Albert-Wang1010/comm-circuits-proj/docs/Comm_Circuits_Final_Proj.pdf

# Design of a Class D AM Transmitter at 1 MHz on a Single 6 V Supply

Christopher Moronta, Caitlin O’Dea, and Albert Wang ELEN E4314, Columbia University, Spring 2026

Abstract—This paper presents the design and simulation of a Class D amplitude-modulation transmitter operating at 1 MHz on a single 6 V supply. The final stage dissipates 84 mW DC while delivering 13.0 mW into a 500 Ω load. Supply-rail modulation produces a 71 % modulation depth (FFT) at 1 kHz with 3.4 % total harmonic distortion. The −3 dB audio passband covers 250 Hz to 5000 Hz, and out-of-band emissions are more than 28 dB below the unmodulated carrier, exceeding the FCC Part 15 mask by 8 dB. The transmitter uses six bipolar transistors and one LM358 op-amp, within the project’s part budget.

I. INTRODUCTION
Although amplitude modulation has been largely supplanted in modern communication, its educational value lies in combining nonlinear switching, RF tuned networks, and audio signal processing into a compact system. A Class D output stage suits the 100 mW DC budget because the switching transistors ideally dissipate no power. We followed a backto-front design flow—tank Q and load first, then switches, RF buffer, and audio chain—and the paper follows the same order.

II. ARCHITECTURE
Fig. 1 shows the complete transmitter schematic, comprising four functional blocks. An audio bandpass filter drives a complementary push-pull buffer through an LM358 unity-gain stage. The buffer feeds the audio transformer; its secondary, in series with an RFC between VDD and the Class D supply rail, produces a low-frequency swing on the otherwise 6 V rail. An RF buffer (powered from the modulated rail, motivation in Section VII) converts the 1 Vpk carrier into base drive for the Class D switching pair, whose output passes through a series LC tank to the 500 Ω load.

III. CLASS D OUTPUT STAGE

A. Series LC Tank
The tank’s quality factor Q is set by the FCC Part 15 emission mask, which requires ≥ 20 dB attenuation at the band edges 510 kHz and 1707 kHz. For a series-tuned RLC bandpass,

H(f)
H(f0)

=

1
s
1 + Q²
f
f0

−

f0
f

2

. | (1)

Evaluating at 1707 kHz gives |f /f0 − f0/f| = 1.12, and 510 kHz gives 1.45. The upper edge is therefore the limiting case; requiring 20 dB attenuation yields Q ≥ 9. We chose

Q = 10 to provide tolerance margin without compressing the audio sidebands at ±5 kHz around the carrier.
With RL = 500 Ω and ω0 = 2π × 1 MHz,

L1 =

QRL
ω0

= 796 µH → 820 µH (standard), (2)

C1 =

1
ω

2
0L1

= 30.9 pF → 30 pF (standard), (3)

giving a measured Q = 10.3 and f0 = 1.015 MHz. The residual offset falls well inside the audio passband and is absorbed by the variable trimmer (10 pF to 500 pF).

B. Complementary Switching Pair
The output transistors are a 2N2907A high-side PNP (Q1, emitter on rail) and a 2N2222A low-side NPN (Q2, emitter on ground), driven 180°out of phase by the RF buffer. Base resistors R2 = R3 = 2.2 kΩ set quiescent base currents of approximately 200 µA, sufficient to saturate each device given βDC > 100 at peak collector currents on the order of 10 mA. The choice of R2,3 has a strong effect on DC power: increasing from 1 kΩ to 2.2 kΩ dropped dissipation from 108 mW to 84 mW, since lighter base loading allows fuller rail swing and reduces conduction overlap.
Speed-up capacitors C9 (across R2) and C2 (across R3), 330 pF each, accelerate switching transitions by bypassing the base resistor at high frequencies. Without them, the RC time constant formed by the base resistor and transistor input capacitance (∼ 25 pF) gives τ ≈ 55 ns, which is significant against the 500 ns carrier half-period. This slow slew rate allows the switching node to traverse its active region gradually, causing brief shoot-through pulses that pull Vrail down through parasitic coupling, wasting DC power. At 1 MHz, the capacitor reactance (≈ 482 Ω) falls well below 2.2 kΩ, so the fast edge bypasses the resistor and charges the base directly, while the resistor still sets the DC bias current limit. We found empirically that 680 pF over-couples and drives the transistor into deep saturation, causing excessive trough overshoot at turn-off, while 330 pF provides the optimal balance between edge speed and overshoot suppression.

IV. RF INPUT BUFFER
The 1 Vpk RF source drives a 2N2222A common-emitter amplifier Q3 through a 100 nF DC-blocking capacitor. The bias divider R7 = 7.5 kΩ and R5 = 680 Ω is referenced to the modulated rail, placing Q3 just below conduction threshold so it operates in Class C with ∼ 30 % duty cycle. This is

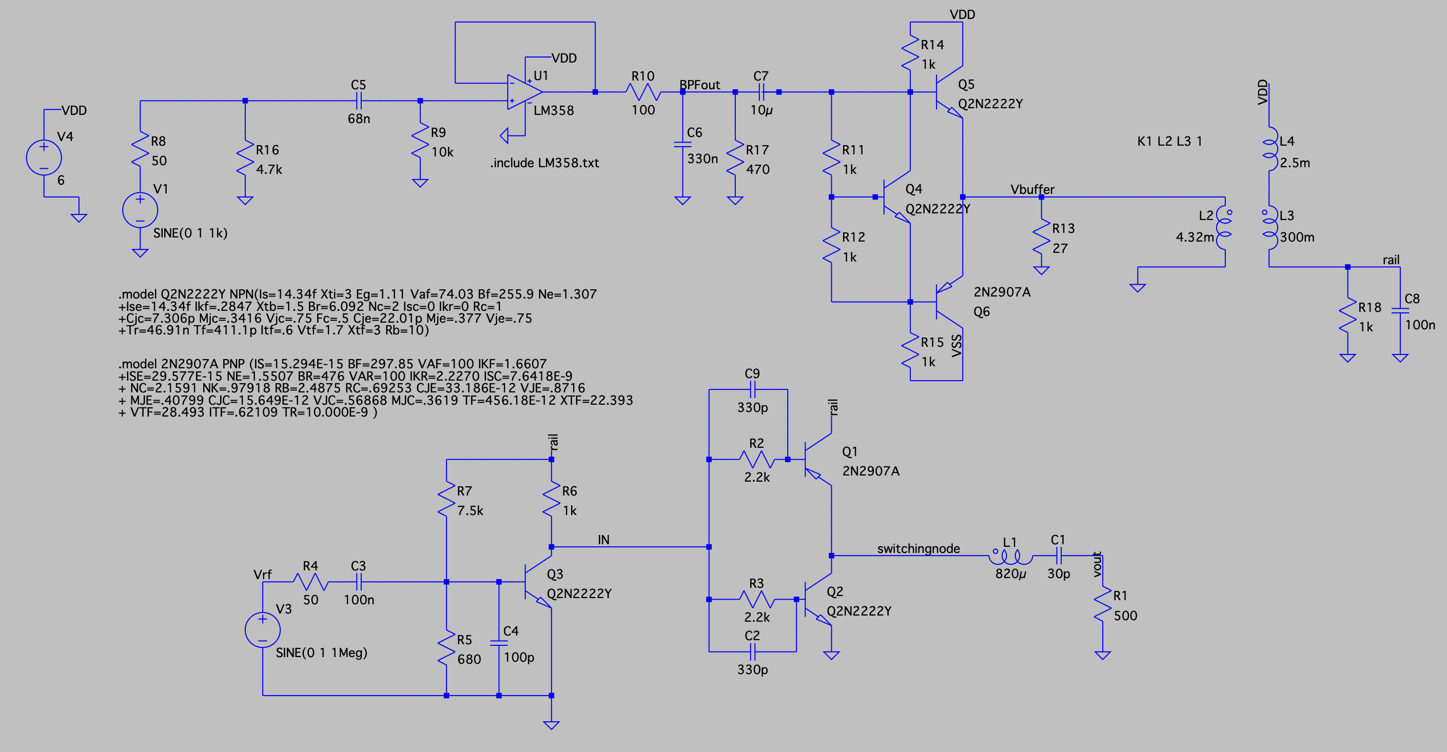
[picture p1: figure]

Fig. 1. Complete LTspice schematic. Top-left: audio bandpass filter and unity buffer (LM358). Top-center: complementary push-pull current buffer with VBE-multiplier biasing (Q4). Top-right: audio transformer (used in reverse for 8.33× step-up) and rail network (RFC L4, bypass C8). Bottom-left: RF input buffer (Q3, Class C). Bottom-right: Class D switching pair (Q1, Q2) and series-LC output tank (L1, C1) into RL = 500 Ω.

acceptable because the high-Q tank rejects all harmonics,
leaving only the 1 MHz fundamental at the switching node.
A 100 pF bypass capacitor C4 across R5 stabilizes the base AC reference. Because R7 is tied to the modulated rail, residual switching ripple and audio-frequency variation would otherwise reach the base and jitter the Class C conduction threshold cycle-to-cycle. C4 shunts these components to ground, locking the threshold and producing a consistent near-square waveform at the collector.
The collector resistor R6 = 1 kΩ delivers a rail-to-rail drive to the bases of Q1 and Q2. Because VR5,R7
scales with
the rail, the buffer’s quiescent point tracks the modulation and the carrier amplitude at the switching node remains a linear function of rail voltage; this linearity is the principal contributor to the low achieved THD.
V. AUDIO MODULATION CHAIN
A. Bandpass Filter
The audio source provides 1 Vpk through a 50 Ω series resistance. A passive high-pass section formed by C5 = 68 nF and R9 = 10 kΩ sets the lower −3 dB corner:

fHP =

1
2πR9C5
= 234 Hz. | (4)

The signal then passes through an LM358 unity-gain buffer U1 (non-inverting input bias set by R9). A passive low-pass section follows, with series R10 = 100 Ω feeding a node loaded by C6 = 330 nF in parallel with R17 = 470 Ω to ground. R17 serves two roles simultaneously: as a DC divider it attenuates by R17/(R10 + R17) = 0.825, trimming the modulation depth from 84 % to the target 71 %; and as part of the Thevenin resistance seen by C6, it sets the upper corner

fLP =

1
2π(R10 ∥ R17) C6
= 5.85 kHz. | (5)

The 234 Hz HPF corner sits closest to the spec edge and proves the tighter of the two endpoints (Section VI).

B. Push-Pull Audio Buffer

The LM358 cannot supply the heavy current required by the transformer primary, whose impedance falls below 10 Ω at the low end of the audio band; a complementary emitter-follower pair (2N2222A Q5 and 2N2907A Q6) provides the necessary current gain. To prevent crossover distortion the bases must be biased ∼ 2VBE apart. Since diodes are not permitted by the part list, we use a VBE multiplier (Q4, 2N2222A) with R11, R12 = 1 kΩ and chain resistors R14, R15 = 1 kΩ setting the quiescent point. Q4’s VCE settles at VBE(1 + R12/R11) and tracks temperature. R13 = 27 Ω at the buffer output establishes a static DC reference for Vbuffer.

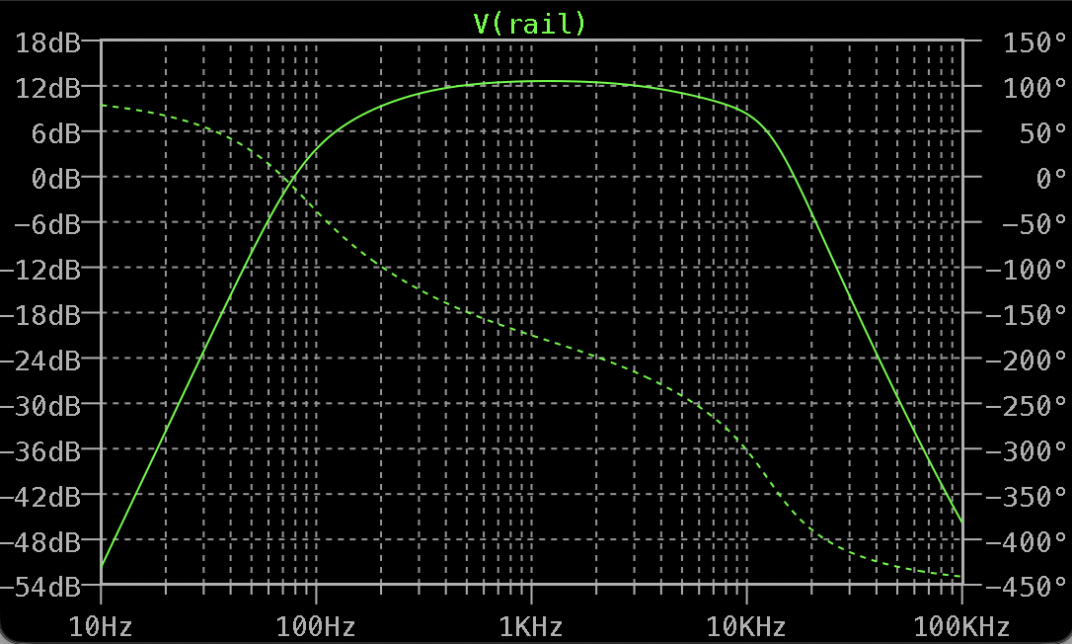
[picture p2: figure]

Fig. 2. Simulated audio-chain transfer function (AC sweep from 10 Hz to 50 kHz). Markers at the −3 dB points indicate the 234 Hz HPF and 5.85 kHz LPF corners, bracketing the required 250 Hz to 5000 Hz audio passband.

C. Transformer and Rail Filtering

The audio transformer is the Mouser 42TL001 (Lp = 300 mH, n = 8.333), connected in reverse so that the 4.32 mH winding (1.1 Ω series resistance) is driven by the push-pull buffer and the 300 mH winding (35 Ω series resistance) couples into the rail. This 8.33× voltage step-up allows a modest buffer swing of ±0.5 Vpk to produce the ±4.2 Vpk of audio swing required for m = 0.7 on a 6 V rail.
The transformer secondary is placed in series with a 2.5 mH RFC (L4) between VDD and the Class D rail. The RFC presents high impedance to 1 MHz switching ripple while passing the audio signal essentially unattenuated, and a 100 nF bypass capacitor C8 shunts residual RF content to ground.

VI. SIMULATION RESULTS

All simulations were performed in LTspice with the manufacturer SPICE models for the 2N2222A, 2N2907A, and LM358. The .tran 0 20m 5m 20n command was used with a 20 ns maximum timestep to resolve the 1 MHz carrier; the first 5 ms was discarded as startup transient. Per the spec, the SPICE power option is not used; all power quantities are computed from voltage and current via .meas commands.

A. Modulated Output and Rail Waveform

Fig. 3 shows the output voltage Vout across RL with 1 kHz audio, displaying clean amplitude modulation of the 1 MHz carrier (envelope between ∼0.93 Vpk and ∼5.5 Vpk). Fig. 4 shows the corresponding rail waveform: it swings between Vrail,max = 9.19 V and Vrail,min = 1.85 V, giving a rail-based modulation depth

mrail =

Vmax − Vmin

Vmax + Vmin

= 0.665. | (6)

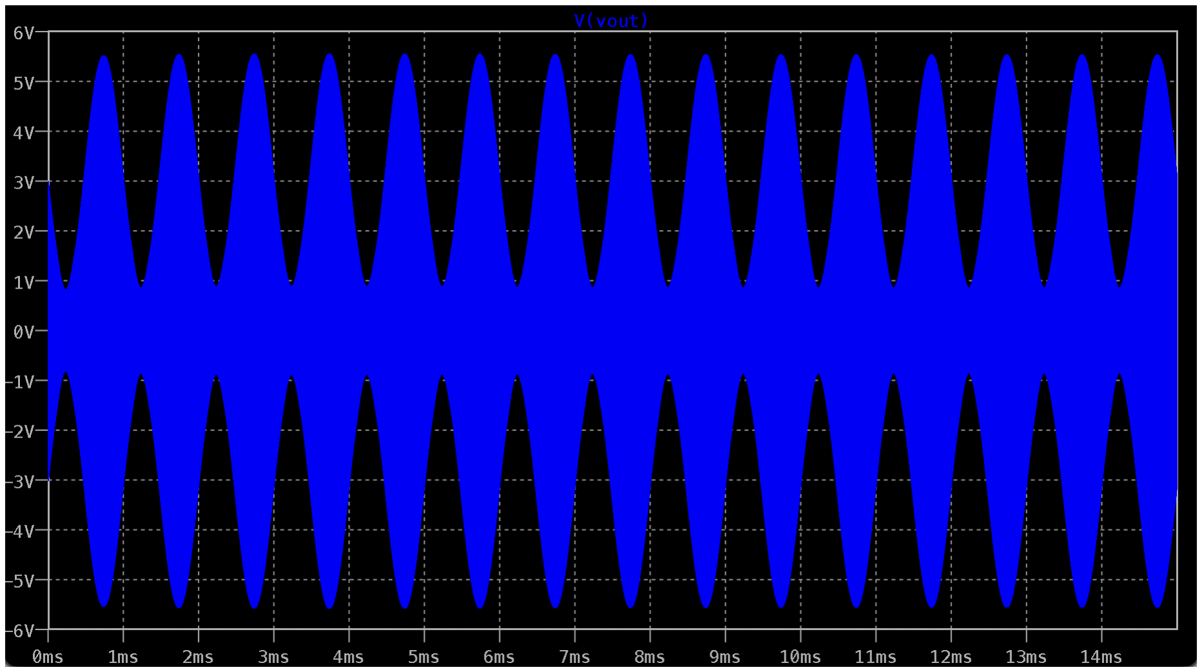
[picture p3: figure]

Fig. 3. | Output voltage Vout across RL | = 500 Ω over 14 ms with
1 kHz audio modulation. The 1 MHz carrier amplitude is modulated between approximately 0.93 Vpk and 5.5 Vpk, consistent with the FFT-measured modulation depth of 71 %.

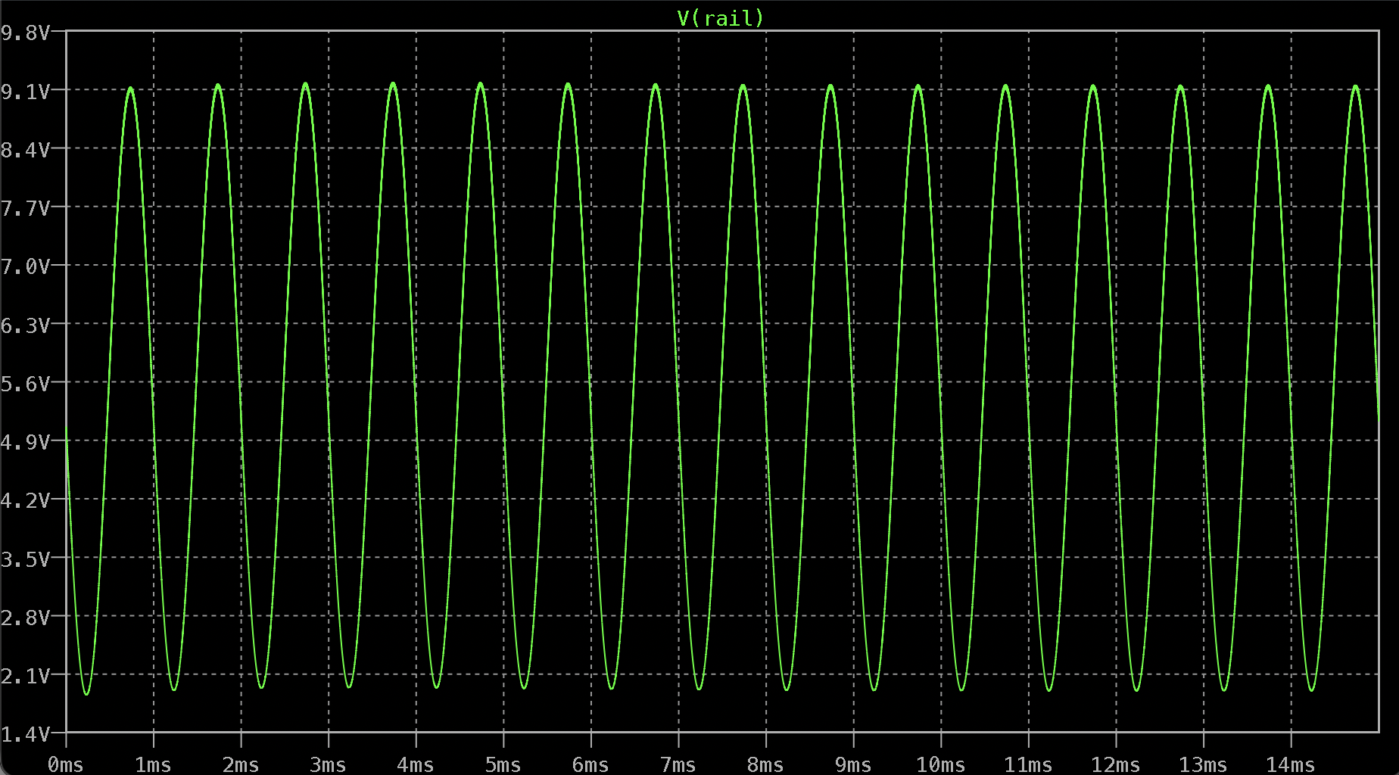
[picture p4: figure]

Fig. 4. Class D supply rail Vrail with 1 kHz audio. Sinusoidal envelope confirms low-distortion supply-rail modulation.

B. Spectrum and THD

The FFT of Vout (Fig. 5) shows the carrier at 1 MHz flanked by the audio sidebands at 1 MHz±1 kHz. From the sidebandto-carrier amplitude ratio,

mFFT = 2 ·

ASB
AC
= 0.71, | (7)

in good agreement with the rail-based estimate (the small discrepancy is due to slight envelope asymmetry, which the time-domain formula penalizes but the FFT does not). The second- and third-order audio sideband distortion products yield a combined THD of 3.4 %, well below the 10 % specification.
Carrier harmonics at 2 MHz and 3 MHz are attenuated by more than 28 dB relative to the unmodulated carrier, exceeding the 20 dB FCC mask by 8 dB of margin.

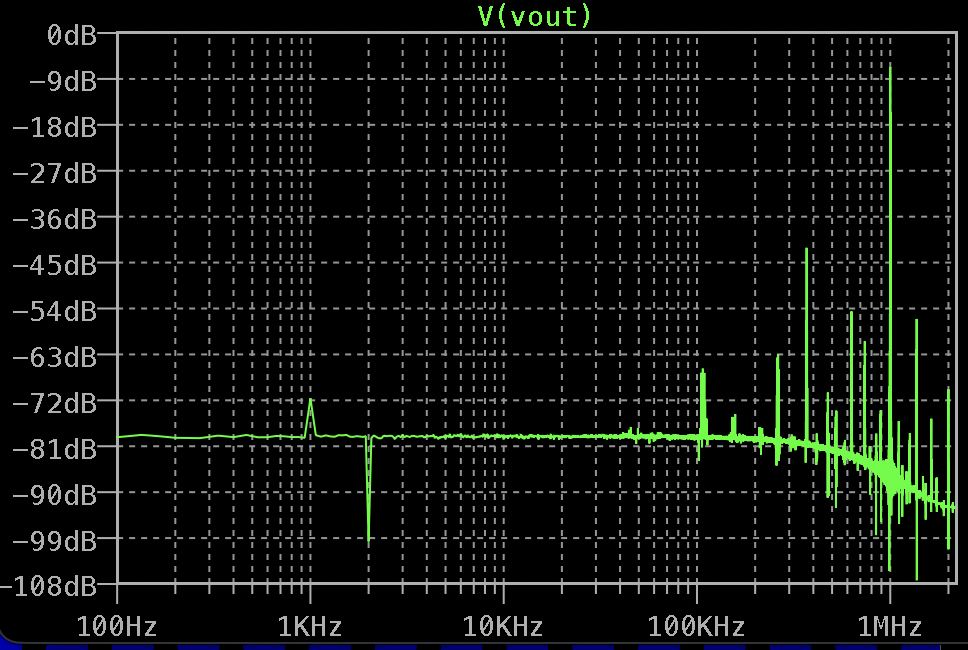
[picture p5: figure]

Fig. 5. FFT of Vout with 1 kHz audio at m = 0.7. Carrier at 1 MHz with audio sidebands at ±1 kHz. Carrier harmonics at 2 MHz, 3 MHz are > 28 dB below the fundamental.

C. Audio Passband Verification
The passband endpoints were verified at 250 Hz and 5 kHz audio. Both satisfy the m ≥ 0.707 m1k = 0.470 (−3 dB) criterion (Table I); Fig. 6 shows the corresponding rail waveforms with clean sinusoidal envelopes at both extremes. The 250 Hz endpoint sits essentially at the threshold, consistent with the HPF corner at 234 Hz being placed close to the spec edge for maximum in-band audio gain.

TABLE I
AUDIO PASSBAND VERIFICATION (RAIL-BASED MODULATION DEPTH)
Audio freq. | Vrail,max | Vrail,min | mrail
250 Hz | 8.31 V | 2.75 V | 0.503
1 kHz | 9.19 V | 1.85 V | 0.665
5 kHz | 8.68 V | 2.37 V | 0.572

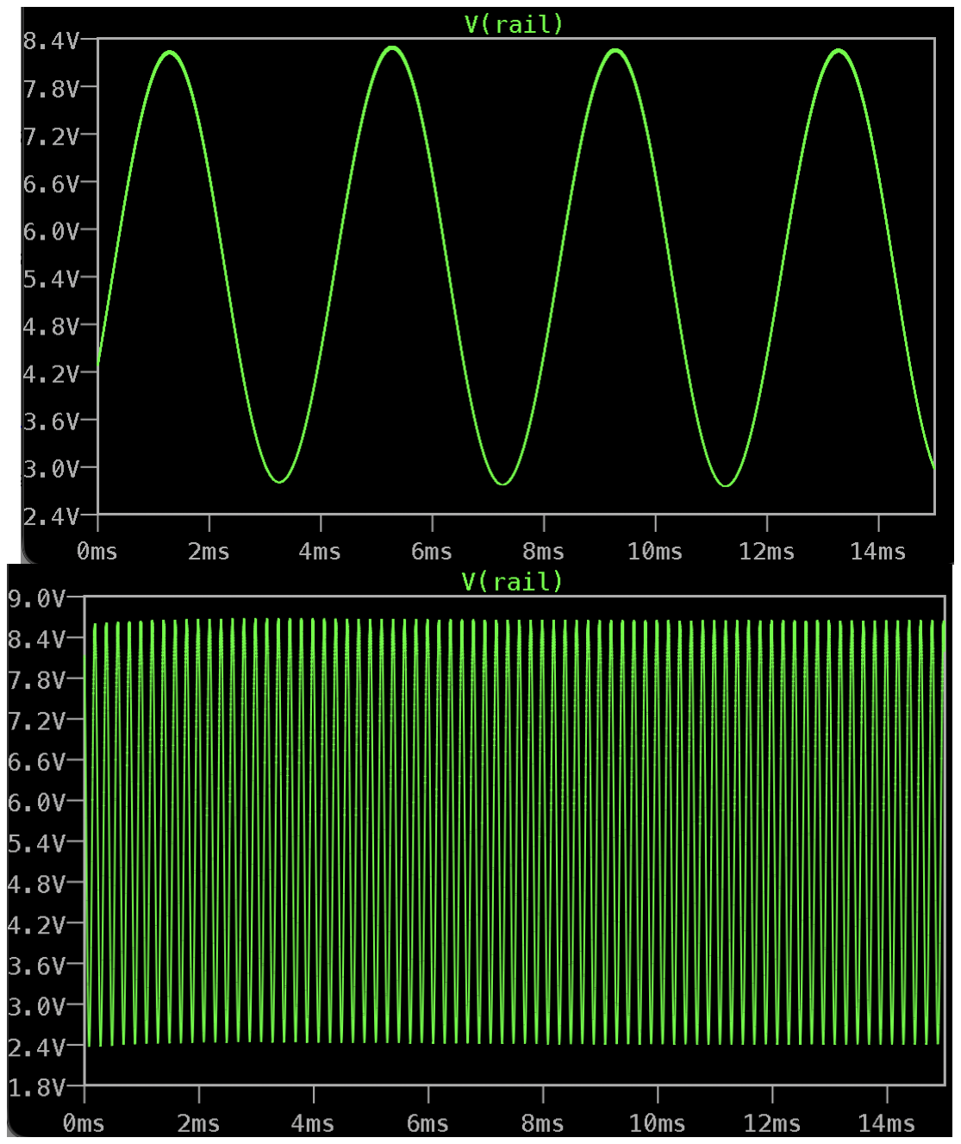
[picture p6: figure]

Fig. 6. Rail voltage at the audio passband endpoints. (Top) 250 Hz; (bottom) 5 kHz. Both envelopes are clean sinusoids.

D. Power Budget
Power results are summarised in Table II. The DC supply current averages 14.0 mA, giving PDC = VDD⟨IL3

⟩ =
84 mW. Output power into the load is 13.0 mW. ⟨Vrail IL3

⟩
contains an audio cross-term from transformer pumping; per the specification the relevant figure is VDD⟨IL3
| ⟩. An additional
1 kΩ resistor R18 at the rail node (a bench-test leftover) contributes ∼ 32 mW of static load; even with this overhead the design clears the 100 mW spec with 16 mW of margin.

TABLE II
SIMULATED POWER BUDGET AT 1 kHz, m = 0.7
Quantity | Value

DC supply current ⟨IL3

⟩ | 14.0 mA
DC dissipation VDD⟨IL3

⟩ 84 mW
Load power V

2
out,rms/RL | 13.0 mW
Specification limit | < 100 mW

VII. DISCUSSION
Two design decisions dominated the path to specification. First, supplying the RF buffer from the modulated rail rather than the static VDD reduced THD from approximately 15 % to under 5 % with no other change; the mechanism is the elimination of a constant-amplitude pedestal in the base drive that would otherwise compress the modulation envelope at high m.
Second, the Class D base resistors R2 = R3 were swept from 1 kΩ to 2.2 kΩ, dropping PDC from 108 mW to 84 mW—the largest single power improvement in the design. Lighter base loading reduces the rail current during conduction and lets the rail swing more fully, which in turn allows the same output power at lower DC.
Robustness to component tolerance was considered throughout. The HPF corner at 234 Hz sits closest to its spec edge; a −5% shift in C5 or R9 would move it upward toward 250 Hz. We accepted this margin because the achieved 50.3 % modulation depth at 250 Hz clears the 47.0 % threshold.

VIII. CONCLUSION
A Class D AM transmitter meeting all course and FCC Part 15 specifications was designed and verified in LTspice. The transmitter operates at 1 MHz on a single 6 V supply, dissipating 84 mW DC in the final stage while delivering 13.0 mW of audio-modulated RF into a 500 Ω load. Modulation depth, distortion, audio passband, and spurious emissions all satisfy the specification, with the FCC emission margin exceeding 8 dB and THD a factor of three below the 10 % ceiling. Complete simulation results, additional figures, and design files are available in [4]

REFERENCES

[1] Y. Tsividis, Operation and Modeling of the MOS Transistor, 3rd ed. Oxford University Press, 2011.
[2] B. Razavi, RF Microelectronics, 2nd ed. Prentice Hall, 2012.
[3] H. L. Krauss, C. W. Bostian, and F. H. Raab, Solid State Radio Engineering. Wiley, 1980.
[4] A. Wang, “Class D AM Transmitter Design Repository,” 2026. [Online]. Available: https://github.com/Albert-Wang1010/comm-circuits-proj

APPENDIX A
FINAL COMPONENT VALUES

Table III lists the complete set of component values used in the final simulation. All resistors and capacitors are standard E12 values.

TABLE III
FINAL COMPONENT VALUES
Block | Component | Value
Audio chain | R8 (source) | 50 Ω
| R16 (shunt) | 4.7 kΩ
| C5 HPF cap | 68 nF
| R9 HPF res | 10 kΩ
| U1 | LM358 (unity buffer)
| R10 LPF series | 100 Ω
| R17 atten./LPF | 470 Ω
| C6 LPF cap | 330 nF
| C7 AC couple | 10 µF
Push-pull buffer | Q5 (NPN), Q6 (PNP) | 2N2222A / 2N2907A
| Q4 (VBE mult.) | 2N2222A
R11, R12 (VBE mult.) 1 kΩ each
| R14, R15 bias chain | 1 kΩ each
| R13 output bias | 27 Ω
Trans- for- mer / rail | T1 | 42TL001 (reverse-wired)
| L2 (driven) | 4.32 mH, Rser = 1.1 Ω
| L3 (rail) | 300 mH, Rser = 35 Ω
| L4 RFC | 2.5 mH
| C8 rail bypass | 100 nF
| R18 rail shunt† | 1 kΩ
RF buffer | R4 source res. | 50 Ω
| C3 AC couple | 100 nF
| R7 bias top | 7.5 kΩ
| R5 bias bottom | 680 Ω
| C4 base bypass | 100 pF
| Q3 | 2N2222A
| R6 collector (to rail) | 1 kΩ
Class D | Q1 high-side PNP | 2N2907A
| Q2 low-side NPN | 2N2222A
| R2, R3 base res | 2.2 kΩ
| C2, C9 speed-up | 330 pF
| L1 tank inductor | 820 µH
| C1 tank capacitor | 30 pF
| R1 load | 500 Ω
†R18 was added for a bench test and retained in the final simulation; see
| Section VI.

APPENDIX B
POWER MEASUREMENT OUTPUT

Fig. 7 reproduces the relevant section of the LTspice error-log output from the .meas commands at 1 kHz audio, m = 0.7.

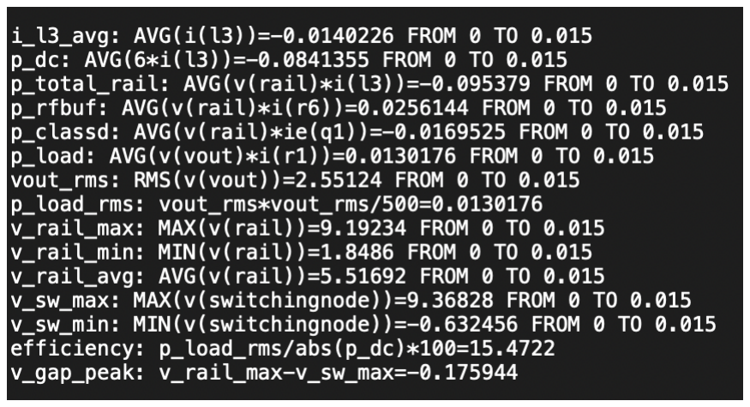
[picture p7: figure]

Fig. 7. LTspice .meas output (error-log excerpt) at 1 kHz audio, m≈0.7. Quantities used in the main body and power budget (Table II) are computed directly from these measurements.

APPENDIX C
OPTIMIZATION HISTORY
The DC power figure converged across the following iterations (all measured at 1 kHz audio, m ≈ 0.7):
1) Baseline (no speed-up, R2,3 = 1 kΩ): PDC = 150 mW.
2) Adding 330 pF speed-up caps: PDC = 133 mW.
3) Increasing speed-up to 680 pF: worsened to 140 mW (trough overshoot). Reverted.
4) Sweeping R6: no net change in DC, only redistributes between prf buf and pclassd via a cross-term.
5) Increasing R2, R3 from 1 kΩ to 2.2 kΩ: PDC = 84 mW. Largest single improvement.
6) Adding R17 = 470 Ω: trimmed m from 84 % to 71 %, PDC = 84 mW.

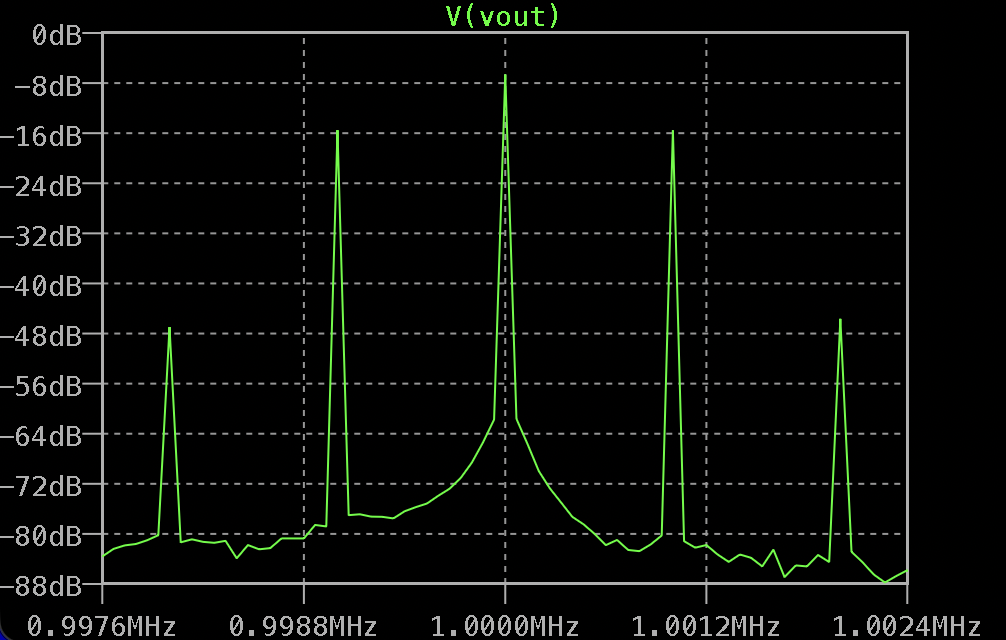
[picture p8: figure]

Fig. 8. FFT zoom near 1 MHz showing audio second- and third-harmonic distortion sidebands at 990 kHz and 985 kHz (5 kHz audio). Both are more than 30 dB below the fundamental sideband.
