Albert-Wang1010/comm-circuits-proj/figures/power_analysis.png

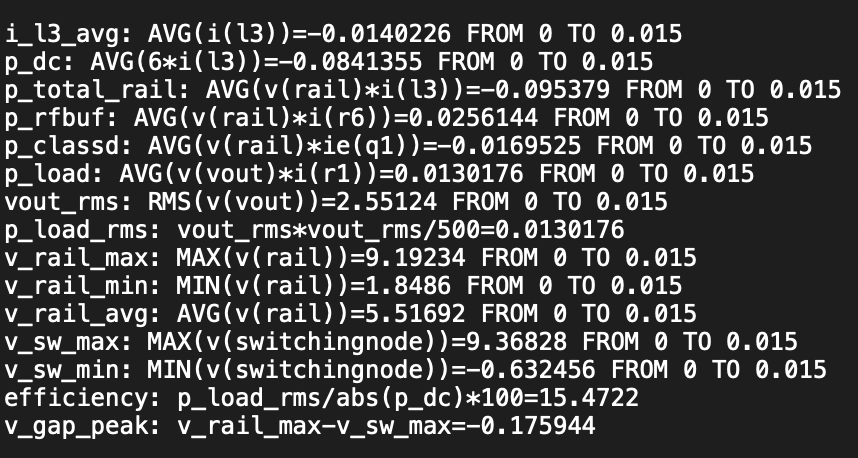
figures/power_analysis.png
