Albert-Wang1010/comm-circuits-proj/figures/vout.png

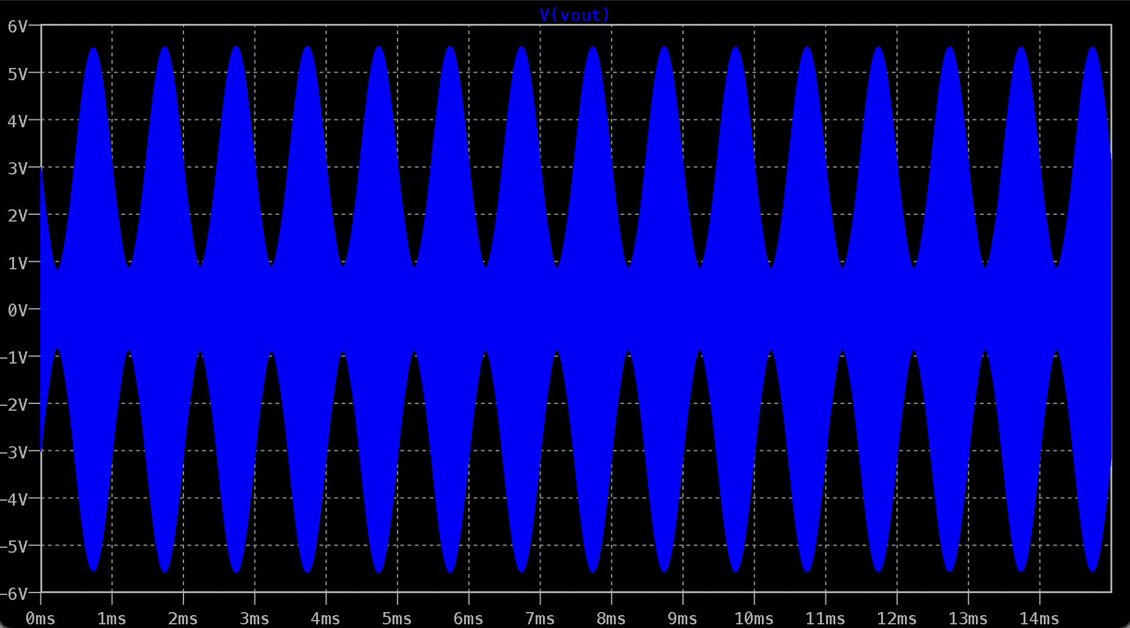
figures/vout.png
