Albert-Wang1010/comm-circuits-proj/sim/am_transmitter.asc

C1: cap; 30p
C2: cap; 330p
C3: cap; 100n
C4: cap; 100p
C5: cap; 68n
C6: cap; 330n
C7: cap; 10µ
C8: cap; 100n
C9: cap; 330p
L1: ind2; 820µ
L2: ind2; 4.32m; Rser=1.1
L3: ind2; 300m; Rser=35
L4: ind; 2.5m
Q1: pnp; 2N2907A
Q2: npn; Q2N2222Y
Q3: npn; Q2N2222Y
Q4: npn; Q2N2222Y
Q5: npn; Q2N2222Y
Q6: pnp; 2N2907A
R1: res; 500
R2: res; 2.2k
R3: res; 2.2k
R4: res; 50
R5: res; 680
R6: res; 1k
R7: res; 7.5k
R8: res; 50
R9: res; 10k
R10: res; 100
R11: res; 1k
R12: res; 1k
R13: res; 27
R14: res; 1k
R15: res; 1k
R16: res; 4.7k
R17: res; 470
R18: res; 1k
U1: opamp2; LM358
V1: voltage; SINE(0 1 250); AC 1
V3: voltage; SINE(0 1 1Meg); AC 1
V4: voltage; 6
Named nets: 0, IN, vout, switchingnode, rail, VDD, VSS, BPFout, Vbuffer, Vrf
.model Q2N2222Y NPN(Is=14.34f Xti=3 Eg=1.11 Vaf=74.03 Bf=255.9 Ne=1.307
+Ise=14.34f Ikf=.2847 Xtb=1.5 Br=6.092 Nc=2 Isc=0 Ikr=0 Rc=1
+Cjc=7.306p Mjc=.3416 Vjc=.75 Fc=.5 Cje=22.01p Mje=.377 Vje=.75
+Tr=46.91n Tf=411.1p Itf=.6 Vtf=1.7 Xtf=3 Rb=10)
.model 2N2907A PNP (IS=15.294E-15 BF=297.85 VAF=100 IKF=1.6607
+ISE=29.577E-15 NE=1.5507 BR=476 VAR=100 IKR=2.2270 ISC=7.6418E-9
+ NC=2.1591 NK=.97918 RB=2.4875 RC=.69253 CJE=33.186E-12 VJE=.8716
+ MJE=.40799 CJC=15.649E-12 VJC=.56868 MJC=.3619 TF=456.18E-12 XTF=22.393
+ VTF=28.493 ITF=.62109 TR=10.000E-9 )
.tran 0 20m 5m 20n
.options plotwinsize=0
* === DC power (the spec metric) ===
.meas TRAN i_l3_avg AVG I(L3)
.meas TRAN p_dc AVG 6*I(L3)
* === Power breakdown for diagnosis ===
.meas TRAN p_total_rail AVG V(rail)*I(L3)
.meas TRAN p_rfbuf AVG V(rail)*I(R6)
.meas TRAN p_classd AVG V(rail)*Ie(Q1)
.meas TRAN p_load AVG V(vout)*I(R1)
* === Load power (RMS-based, more accurate for RF) ===
.meas TRAN vout_rms RMS V(vout)
.meas TRAN p_load_rms PARAM vout_rms*vout_rms/500
* === Rail behavior / modulation depth ===
.meas TRAN v_rail_max MAX V(rail)
.meas TRAN v_rail_min MIN V(rail)
.meas TRAN v_rail_avg AVG V(rail)
* === Switching node saturation check ===
.meas TRAN v_sw_max MAX V(switchingnode)
.meas TRAN v_sw_min MIN V(switchingnode)
* === Efficiency (computed from above) ===
.meas TRAN efficiency PARAM p_load_rms/abs(p_dc)*100
.meas TRAN v_gap_peak PARAM v_rail_max-v_sw_max
.include LM358.txt
K1 L2 L3 1
