Albert-Wang1010/comm-circuits-proj/figures/audio_band_verification/5k.png

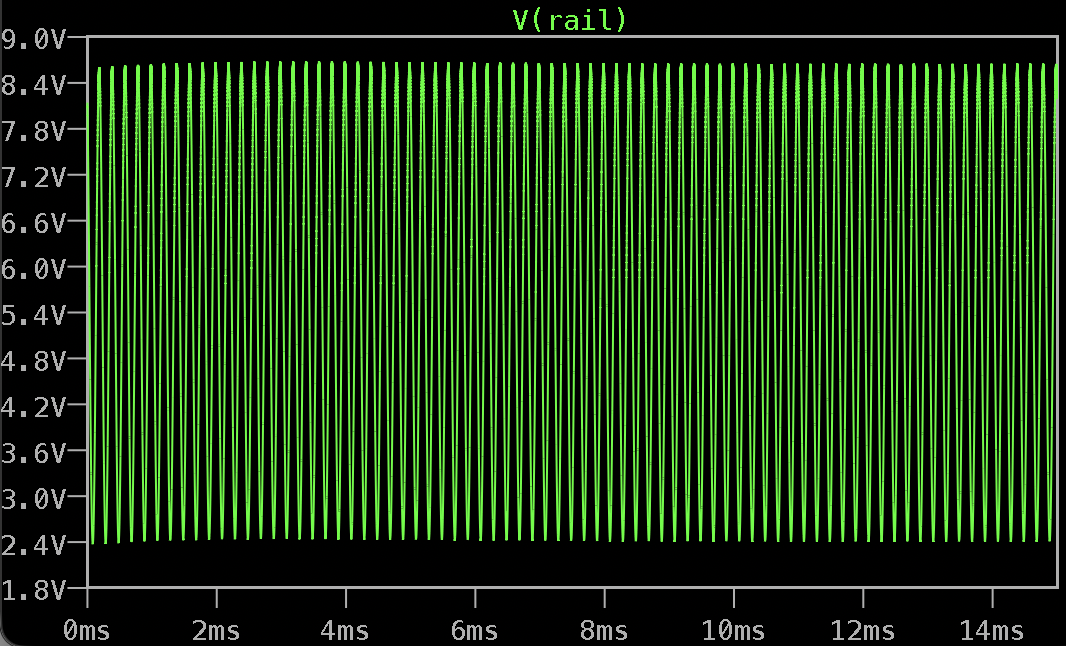
figures/audio_band_verification/5k.png
