Albert-Wang1010/comm-circuits-proj/figures/audio_band_verification/250.png

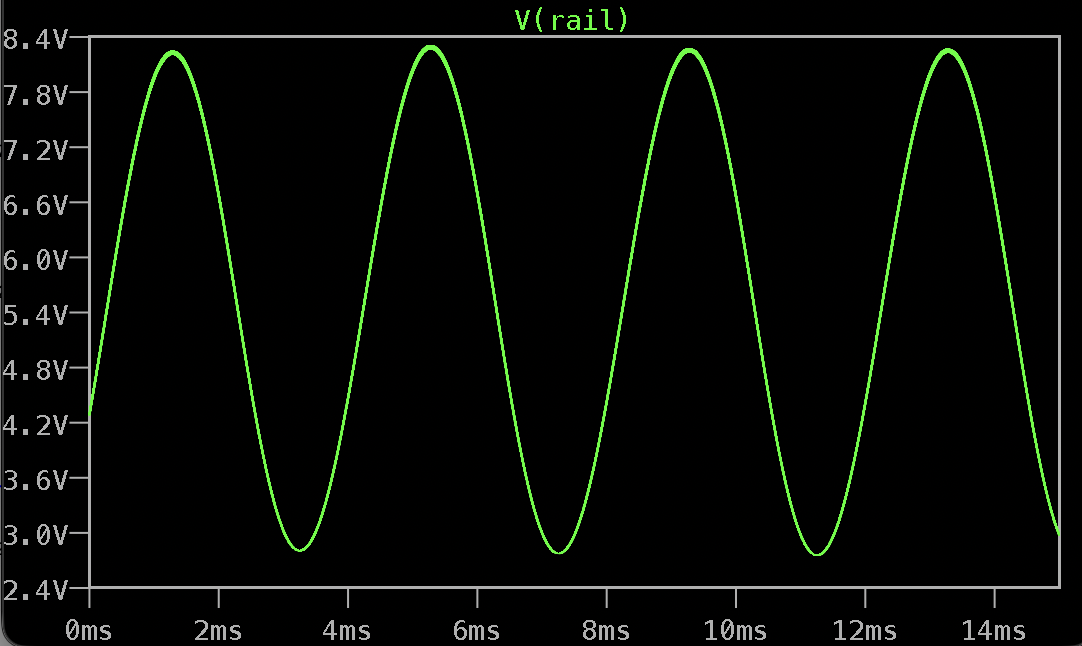
figures/audio_band_verification/250.png
